sanbungi/potato-esp32/README.md

# potato esp32 (WIP)



ESP32-S3で自作HTTPサーバーを移植して、実際にサイトとして稼働させようプロジェクト
