sanbungi/potato-esp32/art/ATTRIBUTION.md

# Artwork attribution

## Potato (silkscreen)

`potato_high_contrast.svg` — "Potato" (High Contrast) from **Fluent Emoji** by Microsoft  
https://github.com/microsoft/fluentui-emoji/tree/main/assets/Potato

基板のシルクスクリーン（表: ESP32 と W5500 の間、裏: Wi-Fi マーク / "powered by" バッジ）に、
このパスを多角形化して使用している。

License: MIT

```
    MIT License

    Copyright (c) Microsoft Corporation.

    Permission is hereby granted, free of charge, to any person obtaining a copy
    of this software and associated documentation files (the "Software"), to deal
    in the Software without restriction, including without limitation the rights
    to use, copy, modify, merge, publish, distribute, sublicense, and/or sell
    copies of the Software, and to permit persons to whom the Software is
    furnished to do so, subject to the following conditions:

    The above copyright notice and this permission notice shall be included in all
    copies or substantial portions of the Software.

    THE SOFTWARE IS PROVIDED "AS IS", WITHOUT WARRANTY OF ANY KIND, EXPRESS OR
    IMPLIED, INCLUDING BUT NOT LIMITED TO THE WARRANTIES OF MERCHANTABILITY,
    FITNESS FOR A PARTICULAR PURPOSE AND NONINFRINGEMENT. IN NO EVENT SHALL THE
    AUTHORS OR COPYRIGHT HOLDERS BE LIABLE FOR ANY CLAIM, DAMAGES OR OTHER
    LIABILITY, WHETHER IN AN ACTION OF CONTRACT, TORT OR OTHERWISE, ARISING FROM,
    OUT OF OR IN CONNECTION WITH THE SOFTWARE OR THE USE OR OTHER DEALINGS IN THE
    SOFTWARE
```

## Title lettering (front silkscreen "ESP32 HTTP")

Font: **Chewy** by Astigmatic (Google Fonts) — Apache License 2.0  
https://github.com/google/fonts/tree/main/apache/chewy

文字はシルク用の多角形に変換済み（基板ファイルにフォント依存なし）。
1 文字ずつ傾き・上下ずれを付け、ポテトの芽に見立てた小穴を開けている。
