sanbungi/potato-esp32/bom_akizuki.csv

リファレンス | 品名 | 型番 | 秋月通販コード | 単価(円) | 入数 | 必要数 | 購入単位数 | 小計(円) | 備考
U1 | Wi-Fiモジュール ESP32-S3-WROOM-1 (16MB/8MB PSRAM) | ESP32-S3-WROOM-1-N16R8 | 117256 | 800 | 1 | 1 | 1 | 800
U2 | 低損失三端子レギュレーター 3.3V1A | LM2940T-3.3 | 114505 | 80 | 1 | 1 | 1 | 80
U3 | 三端子レギュレーター 5V1.5A | NJM7805FA | 108678 | 60 | 1 | 1 | 1 | 60 | U3/U6 はどちらか一方を実装
U6 | LXDC55使用DCDCコンバーターキット (降圧 5V) | AE-LXDC55-5V | 109981 | 450 | 1 | 1 | 1 | 450 | 任意 (U3 の代わり)。入力 6-14V。ピン順は説明書で確認
D1-D3 | ショットキーバリアダイオード 40V1A | 1N5819 | 117244 | 100 | 10 | 3 | 1 | 100
C11-C12 | OS-CON 1000uF6.3V105℃ | 6SEPC1000MD | 108293 | 90 | 1 | 2 | 2 | 180
C8 | チップタンタルコンデンサー 22uF10V 3528 | TAJB226M010R | 101408 | 100 | 10 | 1 | 1 | 100 | LM2940 の出力条件 (22uF 以上・ESR 0.1-1Ω) ぎりぎり
C1 | チップ積層セラミックコンデンサー 22uF25V X5R 2012 |  | 108240 | 120 | 10 | 1 | 1 | 120
C2-C3 | チップ積層セラミックコンデンサー 0.1uF50V 1608 | GRM188F11H104ZA01 | 113374 | 100 | 40 | 2 | 1 | 100
C4/C10 | チップ積層セラミックコンデンサー 4.7uF10V F 1608 | GRM188F11A475ZE20 | 109218 | 200 | 50 | 2 | 1 | 200
C7/C9 | チップ積層セラミックコンデンサー 1uF25V B 1608 |  | 130397 | 100 | 40 | 2 | 1 | 100 | C9 は 7805 入力 (ジャック電圧) のため 25V 品
C5-C6 | チップ積層セラミックコンデンサー 15pF50V NP0 1608 | CC0603N150J500 | 113312 | 100 | 40 | 2 | 1 | 100 | 水晶の負荷容量に応じて要調整
R1-R2 | チップ抵抗 1608 10kΩ | RK73B1JTTD103J | 130355 | 150 | 100 | 2 | 1 | 150
R4-R8 | チップ抵抗 1608 1kΩ | RK73B1JTTD102J | 130351 | 150 | 100 | 5 | 1 | 150 | R4 (PWR LED) は 5V で約 3mA
D4 | 3mm 赤色 LED | OSR5JA3Z74A | 111577 | 10 | 1 | 1 | 1 | 10 | PWR
D5 | 3mm 緑色 LED | OSG5TA3Z74A | 111635 | 20 | 1 | 1 | 1 | 20 | 3V3
D6 | 3mm 黄色 LED | OSY5JA3Z74A | 111639 | 20 | 1 | 1 | 1 | 20 | STAT
D7-D8 | 3mm オレンジ色 LED 低消費 | OSO5PA3133A-1MA | 116909 | 230 | 10 | 2 | 1 | 230 | LAN / SD
J1 | 基板取付用 USB コネクター B タイプ メス | 5075BR-04-WH | 100161 | 50 | 1 | 1 | 1 | 50 | 専用フットプリント esp32s3_http:USB_B_5075BR-04
J2 | 2.1mm 標準 DC ジャック 基板取付用 | MJ-179PH | 106568 | 40 | 1 | 1 | 1 | 40 | 専用フットプリント esp32s3_http:DCJack_MJ-179PH
J3/J4 | ピンヘッダー 2x40 (80P) | PH-2x40SG | 100082 | 70 | 1 | 1 | 1 | 70 | 2x4 と 2x6 に切って使用
SW1-SW2 | タクトスイッチ 表面実装 6x6mm | TS-06104 | 115969 | 30 | 1 | 2 | 2 | 60 | 専用フットプリント esp32s3_http:SW_TS-06104
Y1 | クリスタル 32.768kHz 円筒 2x6mm | VT-200-F | 104005 | 30 | 1 | 1 | 1 | 30
U4 | W5500 イーサネットモジュール (12ピン) |  |  |  |  | 1 |  |  | 秋月に取扱なし (Amazon 等で調達)
U5 | microSD カードモジュール (5V/レベル変換付き 6ピン) |  |  |  |  | 1 |  |  | 秋月に取扱なし。AE-MICRO-SD-DIP (105488) はピン配置・電源が異なる
合計 |  |  |  |  |  |  |  | 3220 | U4/U5・送料を除く。価格と在庫は 2026-10-04 時点
