sanbungi/potato-esp32/(commit log)

2026-10-04 Initial commit: ESP32-S3 HTTP board KiCad project
    [esp32s3_http.kicad_pcb, esp32s3_http.kicad_sch]
2026-10-04 回路図: 電源部品の見直し、SDピン移動、UARTヘッダ追加、ERCエラー解消
    - D1-D3: 1N5819 (THT ショットキー, DO-41)
    - U2: LM2940T-3.3, U3: NJM7805FA (TO-220F)
    - C8: 47uF タンタル (LM2940 の出力 ESR 0.1-1Ω 要件)
    - C1: 22uF/10V, 0805
    - SD: IO3/IO46/IO9/IO10 -> IO9/IO10/IO11/IO12 (ストラッピングピン回避, 並び順は維持)
    - J3: UART0 デバッグヘッダ (TX/RX/GND)
    - 未使用ピンに未接続フラグ, PWR_FLAG 追加, U6 シンボルをライブラリと同期
    [esp32s3_http.kicad_sch]
2026-10-04 PCB: 回路図から更新 (F8, KiCad GUI)
    [esp32s3_http.kicad_pcb, esp32s3_http.kicad_sch]
2026-10-04 PCB: 配置見直し、Freerouting による初回配線 (WIP)
    [esp32s3_http.kicad_pcb]
2026-10-04 PCB: W5500/SD のピン割当を配線向きに変更、EN/デカップリング集約、GND ステッチング
    - W5500: IO9-IO14 (U1 左辺), SD: IO38-IO41 (U1 下辺, U5 直上)
    - C2 を U1 pin1/2 直上に、EN 回路を pin3 直上に集約
    - U1 EPAD サーマルビア 0.2 -> 0.3mm
    - Power/GND ネットクラス (0.6mm) 追加
    [esp32s3_http.kicad_pcb, esp32s3_http.kicad_sch]
2026-10-04 PCB: 配線完了、シルク整理
    - W5500 バス・VDD33 幹線・EN/デカップリングを固定配線、残りを Freerouting で配線
    - GND ステッチングビア、値表示を F.Fab へ、リファレンス位置調整
    - DRC: 未配線 0、電気的違反 0 (残りは U3/U6 重ね置き等の意図的なもの)
    [esp32s3_http.kicad_pcb]
2026-10-04 回路図: OS-CON 1000uF (6SEPC1000MD) を W5500 と ESP32 の VDD33 に追加
    [esp32s3_http.kicad_pcb, esp32s3_http.kicad_sch]
2026-10-04 PCB: OS-CON 1000uF (C11: W5500 給電点, C12: LM2940 出力/ESP32 幹線起点) を追加
    [esp32s3_http.kicad_pcb]
2026-10-04 回路図: 動作確認用 LED (PWR/3V3/STAT/LAN/SD) を追加
    - D4 PWR(5V), D5 3V3, D6 STAT(IO21), D7 LAN(W5500_CS アクティブ), D8 SD(SD_CS アクティブ)
    - LED は 3mm THT、抵抗は 0603
    [esp32s3_http.kicad_sch]
2026-10-04 PCB: 動作確認用 LED を追加
    - PWR/3V3/STAT を左端パネルに、LAN は W5500 バス下、SD は U5 横に配置
    - LAN/SD は VDD33→LED→R→CS 構成 (アノードを近傍の VDD33 に直結)
    [esp32s3_http.kicad_pcb, esp32s3_http.kicad_sch]
2026-10-04 回路図: 空き GPIO をピンヘッダに引き出し
    - J3 (2x4): UART0 TX/RX, IO1, IO2, IO42, IO47, IO48, GND
    - J4 (2x6): 5V, 3V3, GND x2, IO3-IO8, IO17, IO18
    - IO45/IO46 (ストラッピング), IO35-37 (PSRAM), IO15/16 (32k 水晶) は除外
    [esp32s3_http.kicad_sch]
2026-10-04 PCB: GPIO ヘッダ J3(2x4)/J4(2x6) 追加、ボタンを左下へ移動
    - J4 を上端 (旧ボタン位置) に、J3 を U1 右下に配置、ピン名をシルク表示
    - SW1/SW2/R2 を左下へ、EN は B.Cu で基板外周を固定配線
    [esp32s3_http.kicad_pcb]
2026-10-04 秋月電子 部品調達リスト (bom_akizuki.csv) を追加
    [bom_akizuki.csv]
2026-10-04 回路図: 部品値を秋月の調達品に合わせる
    - C8 47uF -> 22uF Ta, C4/C10 3.3uF -> 4.7uF, C9 3.3uF -> 1uF/25V
    - C5/C6 12pF -> 15pF, R4 2.2k -> 1k
    [bom_akizuki.csv, esp32s3_http.kicad_pcb, esp32s3_http.kicad_sch]
2026-10-04 SW1/SW2 と J2 を秋月品 (TS-06104 / MJ-179PH) 用フットプリントに変更
    - プロジェクトローカルライブラリ esp32s3_http.pretty を追加 (${KIPRJMOD})
    - SW_TS-06104: データシート P.C.B LAYOUT 準拠 (10.0/6.4 x 5.5/3.5)
    - DCJack_MJ-179PH: スロット穴 3 本、部品面視 (データシートの穴図は半田面視)
    [bom_akizuki.csv, esp32s3_http.kicad_pcb, esp32s3_http.kicad_sch]
2026-10-04 J1 を秋月品 USB-B (5075BR-04) 用フットプリントに変更
    - データシート PCB LAYOUT 準拠: 信号 2.50x2.00 d0.92, シェル 12.04 間隔 d2.30
    - 旧 Lumberg 2411-02 からシェル穴位置が 0.15mm 異なる
    [bom_akizuki.csv, esp32s3_http.kicad_pcb, esp32s3_http.kicad_sch]
2026-10-04 PCB: 基板の角を R3 に、シルクスクリーンを装飾
    - 表: 縦書きタイトル (ESP32-S3 白抜き + HTTP)、RESET/BOOT ラベル
    - 裏: 八角形タイトルパネル (ロゴ・仕様・rev・設計者)、Wi-Fi マーク (アンテナ方向)、
    端のコネクタ表示 LAN/USB/DC 7.5-12V とセンタープラス極性記号
    - 装飾部はステッチングビアを除外、小文字はストロークフォント (0.15mm)
    [esp32s3_http.kicad_pcb]
2026-10-04 シルク: ポテトサーバーのテーマでポテトを配置
    - 表: ESP32 と W5500 の間にポテト (9mm アウトライン)、下の F.Cu は配線禁止にして迂回
    - 裏: パネル副題を POTATO SERVER に、"powered by <ポテト>" バッジ、
    Wi-Fi マークの発信源をポテトに
    - 画像: Fluent Emoji Potato (MIT, Microsoft) — art/ATTRIBUTION.md
    [esp32s3_http.kicad_pcb]
2026-10-04 シルク: ポテトを表裏に散らして転がっている感じに
    - 表 24 個 / 裏 40 個、大きさ・向きランダム (固定シード)
    - パッド・配線・ビア・穴・部品外形・既存シルク・基板端を避けて自動配置
    - 大きいものはアウトライン、小さいものは塗りつぶし
    [esp32s3_http.kicad_pcb]
2026-10-04 シルク: 表のタイトルを「ポテトでできた」おちゃめな文字に
    - Chewy フォントを多角形化、1 文字ずつランダムな傾き・上下のゆらぎ
    - 各文字にポテトの芽の小穴、ESP32 と HTTP の間に小さなポテト
    - art/ATTRIBUTION.md に Chewy (Apache-2.0) を追記
    [esp32s3_http.kicad_pcb]
2026-10-05 J2 (MJ-179PH): GND をスリーブ端子に接続 (パッド 2/3 の番号を修正)
    フットプリントのパッド番号がデータシートと入れ替わっており、GND が
    スイッチ端子 B (プラグ挿入で開放) に接続されていたため、AC アダプタ
    挿入時に GND が切れて給電できなかった。
    - パッド 2 = S (スリーブ, 中央下) を GND に
    - パッド 3 = B (スイッチ, 側面) を未接続に
    - PCB の J2 も同様に修正し、GND ゾーンを再充填
    [esp32s3_http.kicad_pcb]
2026-10-05 W5500/SD の電源電圧をはんだジャンパで切替可能に (JP1/JP2)
    3 パッドのはんだジャンパ (1-2 パターン接続済み) を B 面に追加。
    既定値は従来どおりで、変更時は 1-2 間をカットし 2-3 をはんだでブリッジする。
    - JP1 (W5500, U4 の裏): 1=VDD33 (既定) / 2=W5500_VCC / 3=5V
    - JP2 (SD, U5 ピン列の左): 1=5V (既定) / 2=SD_VCC / 3=VDD33
    - C11 (W5500 給電点の OS-CON) は W5500_VCC 側に移動 (6.3V 品なので 5V でも可)
    - B 面シルクに切替方法を表記、回路図に注記を追加
    - ERC 0、DRC は既存の警告のみ (未接続 0、回路図との差異 0)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
    [esp32s3_http.kicad_pcb, esp32s3_http.kicad_sch]
